Rutger505/real-life-soundboard/(list of files, cad)

Other CAD files:
esp32/case/real-live-soundboard.scad
