Rutger505/real-life-soundboard/(commit log)

2026-08-01 Initial commit: ESP32 BLE firmware + Android Compose soundboard app
2026-08-01 Android: run BLE + audio in a foreground service
    Move BLE connection and playback into SoundboardService so the soundboard
    keeps working while the phone is used normally, screen off, or app closed.
    Ongoing notification shows connection status and the last pressed button.
2026-08-01 esp32: pin esp Rust toolchain via rust-toolchain.toml
    Fixes 'can't find crate for core' — the Xtensa target requires the esp
    toolchain installed by espup, not the default stable toolchain.
2026-08-01 Fix builds: bump esp-idf crates for c_char fix + add kotlin-android plugin
    esp32: bump esp-idf-svc 0.49->0.52 and esp-idf-hal 0.44->0.46 (embuild 0.33)
    to fix the 'c_char vs i8' compile error on newer Xtensa rustc toolchains
    (esp-idf-svc #570, fixed in 0.52.0).
    android: add missing kotlin-android plugin alias to libs.versions.toml that
    app/build.gradle.kts references.
2026-08-01 esp32: bump ESP-IDF to v5.4.2 to match esp-idf-svc 0.52
    esp-idf-svc 0.52 references BLE symbols (esp_ble_gattc_enh_open,
    esp_ble_conn_params_t, ble_llcp_disc_flag, esp_ble_resolve_adv_data_by_type)
    that only exist in ESP-IDF 5.3+. Pinning v5.2.2 caused ~18 unresolved-symbol
    errors inside esp-idf-svc.
2026-08-01 esp32: rewrite BLE server for esp-idf-svc 0.52 API + create GATT service
    - Adapt to esp-idf-hal 0.46 / esp-idf-svc 0.52 API:
    - PinDriver is now single-generic and type-erased -> buttons in one array
    - PinDriver::input takes Pull; set_pull is private
    - BtDriver<'d, Ble> mode marker instead of BleEnabled trait
    - GattsEvent variants: ServiceRegistered{app_id}, ServiceCreated,
    CharacteristicAdded, DescriptorAdded, PeerConnected/PeerDisconnected, Write
    - Actually create the service + notify characteristic + CCCD (0x2902) so
    button presses are sent as BLE notifications (previously never created,
    so nothing was ever sent). Notify all subscribed connections with [index].
    - Restart ad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
2026-08-01 esp32: drop needless mut on buttons array
2026-08-01 esp32: make LED blink non-blocking
    Replace the sleeping blink_led() with a timestamp-driven LedBlinker that the
    main loop advances each tick, so button scanning and BLE notifications are no
    longer stalled ~320ms per press.
    [main.rs]
2026-08-01 esp32: move button 1 (index 1) off GPIO5 to GPIO23
    GPIO5 is a strapping pin and reads unreliably as an input on some boards.
    GPIO23 is a plain GPIO. Update wiring table accordingly.
2026-08-01 android: preload audio for instant playback
    Pressing play was slow because each press did setDataSource + prepare()
    (blocking I/O) on a fresh MediaPlayer. Now each slot keeps a MediaPlayer
    prepared ahead of time (prepareAsync); a press only does seekTo(0)+start().
    Service preloads all slots on start and on config change (ACTION_RELOAD),
    triggered from ViewModel.setAudioFile.
2026-08-01 android: fix crash when replacing a slot's audio file
    preload() released the old MediaPlayer but left 'current' dangling to it;
    the next play() called isPlaying() on the released player -> IllegalStateException.
    Clear 'current' when releasing that player, mirroring clear().
2026-08-01 esp32: restructure firmware around idle power draw
    The device runs off a small LiPo on the wrist, so battery life is decided
    by what the chip does while nothing happens. Split main.rs into ble,
    buttons, led and power modules and tune each for that.
    - buttons: replace the 20 ms poll loop, which woke the CPU 50x/s for nine
    register reads, with GPIO interrupts that unblock the main task. GPIO
    wakeup from light sleep is level-triggered only and gpio_wakeup_enable
    writes the pin's interrupt type, so the pins trigger on low level and are
    only re-armed once every button reads released again -- which is also
    what stops a held button from re-triggering.
    - power: esp_pm_configure at 80/40 M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
    [ble.rs, buttons.rs, led.rs, main.rs, power.rs]
2026-08-04 android: MyInstants integration + move BLE status to bottom
    Add an in-app MyInstants browser so users can find and add sounds without
    leaving the app: search/trending backed by the unofficial MyInstants JSON
    API (myinstants-api.vercel.app), tap a result to download its mp3 into app
    storage and assign it to a slot. The downloaded file is preloaded by the
    service like any picked file, so playback stays instant.
    Each slot gets a search action next to the file picker. Downloads are
    served via a FileProvider and stored under filesDir/myinstants.
    Also move the ESP32 connection status from the top of the screen to a
    compact bar at the bottom, so it no longer sits under the camera cutout.
2026-08-04 android: low-power BLE reconnect backoff
    Reduce battery drain while the ESP32 is switched off. The first reconnect
    after a drop still scans aggressively (SCAN_MODE_LOW_LATENCY, 5s) for a fast
    recovery, but subsequent attempts back off to a steady 10s cadence using
    SCAN_MODE_LOW_POWER instead of hammering low-latency scans forever.
    The backoff counter resets on a successful connection, so a later drop
    retries quickly again.
2026-08-04 android: safe-area layout + always-available source row + play/trash row
    Three UI fixes:
    - Wrap the screen in safeDrawing insets and center the grid vertically, so
    content never lands under the camera cutout / status bar and sits in the
    usable middle of the screen.
    - Keep both source pickers (local file + MyInstants search) available at all
    times, so a filled slot can still be re-sourced from MyInstants.
    - When a slot has audio, show a second row with play + trash (empty slot)
    actions, backed by a new clearSlot() on the ViewModel.
2026-08-05 android: always show play/trash row (disabled when slot is empty)
    Split slot actions into a source row and a playback row, and always render
    play/trash instead of conditionally hiding them. When no sound is loaded the
    playback actions are disabled/greyed rather than removed, so the buttons are
    visible on every tile. Bumped tile min-height to fit both rows.
2026-08-05 android: overlay slot buttons so the sound name stays visible
    Wrap the tile in a Box and overlay the 2x2 action buttons at the bottom
    (position:absolute-style) instead of stacking them in the column. The number
    and name are centered and fill the tile, so the name is no longer pushed out
    by the button rows.
2026-08-05 android: drop absolute-style overlay, use natural-size flow
    Replace the Box overlay with a plain Column so every child (number, sound
    name, source row, playback row) takes its own natural size and the tile grows
    to fit. The selected sound name is no longer clipped or covered by buttons.
2026-08-16 esp32: use internal pull-down resistors for buttons
    Switch button inputs from internal pull-ups to pull-downs (press = high),
    inverting the interrupt/level/scan logic accordingly. No external resistors
    needed; wire each button between its GPIO and 3.3V.
    Move the two strapping pins GPIO12/GPIO15 to GPIO25/GPIO26, which are unsafe
    at boot when driven by a pull-down.
    [buttons.rs, main.rs]
2026-08-17 docs: update wiring for pull-down buttons (GPIO12/15 -> 25/26)
2026-08-18 esp32: rewrite firmware from ESP-IDF std to bare-metal no_std
    Replace the ESP-IDF/std stack (esp-idf-svc/-hal, Bluedroid, embuild,
    sdkconfig.defaults) with a true bare-metal no_std build on esp-hal +
    Embassy (esp-rtos) + the esp-radio BLE controller + the trouble-host
    GATT stack. Target is now xtensa-esp32-none-elf.
    Behavior is preserved exactly:
    - GATT server "Soundboard", service 12345678-…-9012, notify characteristic
    12345678-…-9abc (+ auto CCCD 0x2902); one byte = button index on press.
    - Advertise until connected (single connection), 100–200 ms interval; the
    controller stops advertising on connect. Low-power connection params
    (30–45 ms interval, 20-event slave latency, 4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
    [ble.rs, build.rs, buttons.rs, led.rs, main.rs, power.rs]
2026-08-20 Refactor esp32 comments: strip AI tells (em dashes, colon crutches)
2026-08-20 Rewrite esp32 comments: shorter, less noise
    [ble.rs, buttons.rs, led.rs, main.rs]
2026-08-29 case: add printed enclosure and document it
    Three-part OpenSCAD enclosure (tray, lid, button carrier plate) sized from
    the measured battery, ESP32, charger and buck-boost. The 3x3 button grid is
    centred on the case, so it sits above the ESP32 and that board sets the
    cavity depth.
    btn_leg is 3 mm, which leaves the switch legs standing 1.3 mm proud of the
    carrier plate. That is enough to solder the common 3.3 V rail and the nine
    signal wires from below once the plate is on, instead of wiring the switches
    before they go in.
    The lid has no LED window yet.
    [real-live-soundboard.scad]
2026-08-29 case: add a socket and light hole for the status LED
    The firmware has always driven a status LED on GPIO2 but the lid had no
    opening for it. The socket hangs from the lid underside like a button
    pocket and sits in the gap between the charger and the power switch, the
    one patch of the front band that no module and no carrier plate reaches,
    so it has the full cavity height.
    The light hole is 2.2 mm against a 3 mm body, so the LED is captured and
    cannot be pushed out through the top.
    [real-live-soundboard.scad]
2026-08-29 case: drop the strap lugs
    They were never going to be used, so this removes the lugs, their slots and
    the parameters behind them rather than leaving a disabled flag. The tray
    outline is now the plain rounded rectangle, 61.2 x 97.3 mm, with nothing
    sticking out past it.
    [real-live-soundboard.scad]
2026-08-29 case: size the LED socket on the measured lip, not the body
    The bore was 3.4 mm against a lip measured at 3.3, which leaves 0.05 mm a
    side on the widest part of the LED and will not go together once print
    tolerance is counted. The bore still grips the 3.0 mm body, and the top
    1.2 mm now opens out to 3.7 mm so the lip has somewhere to sit.
    [real-live-soundboard.scad]
2026-08-29 case: move the status LED to the front right corner
    It sat mid-front between the charger and the switch, which reads as an
    arbitrary spot on the lid. Over the power switch it lines up with the other
    thing you interact with, and it is as far into the corner as the screw boss
    lets it go.
    The switch is 4 mm tall against a 12.6 mm cavity, so the socket still hangs
    free with 4.6 mm to spare, and it clears the lid lip by 0.95 mm.
    [real-live-soundboard.scad]
2026-08-30 case: ignore generated STLs
    Claude-Session: https://claude.ai/code/session_01Srfqsck5U9y2Wjd3d172or
2026-08-30 case: stand the charger off the tray floor
    The TP4056 is linear, so it dissipates the drop from 5 V to the cell as
    heat. Averaged over the case that is a few degrees and harmless, but the
    module sat flat on 1.2 mm of floor, and the patch under the chip conducts
    rather than convects. Four 3 mm pads lift it 1.5 mm so it radiates into the
    cavity instead.
    The corner retainers grew by the same 1.5 mm to keep holding the board at
    its own edges, and the USB-C opening moved up with the connector.
    [real-live-soundboard.scad]
2026-09-07 case: compact layout, merge retainers into walls and band dividers
    [real-live-soundboard.scad]
2026-09-07 case: fix dividers being cut away, keep LED relative to the wall, add charger ribs
    [real-live-soundboard.scad]
2026-09-07 case: buck-boost against the left wall, out of the charger rib
    [real-live-soundboard.scad]
2026-09-07 case: add open part option (assembly without lid)
    [real-live-soundboard.scad]
2026-09-13 esp32: read the buttons as a 3x3 matrix
    The nine buttons sit in a 3x3 grid, so wire them as a matrix: 6 GPIOs
    instead of 9, and 6 wires out of the lid instead of 10.
    Rows (GPIO25/26/27) are inputs with the internal pull-up, columns
    (GPIO17/16/4) are open-drain outputs. Open-drain means a column can only
    pull low, so two keys held in one row can't short two outputs together.
    While idle all columns sit low and the task sleeps on the rows; it only
    scans while a key is down. A press reports immediately, a release needs
    four clean 5 ms scans, so bounce can't send twice. Indices stay 0..=8, so
    the app needs no change.
    README documents the pins, the index layout and optional diodes against
    ghosti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
    [buttons.rs, main.rs]
2026-09-13 case: open ESP32 corners, roomier battery, key caps
    The battery squeezed hard enough to damage its leads. Its pocket is now
    1 mm wider and 3 mm longer, and at both front corners (facing the ESP32)
    the front and side ribs stop 10 mm short so the leads can bend freely.
    The ESP32 dividers are gone. Four corner posts against the side walls
    hold the board and carry the button plate, so both pin rows are open for
    wires soldered straight onto the board. The plate sits 8 mm higher over
    the board and gets ribs under its front and back edges, since it now
    spans the full width.
    The bare 3.3 mm actuators were hard to press. Each button gets a printed
    cap with a 7 mm dished top in a lid bore, held in b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
    [real-live-soundboard.scad]
2026-09-13 esp32: move status LED to GPIO18, explain matrix orientation
    GPIO2 also drives the dev board's own LED. GPIO18 sits on the column
    header, is not a strapping pin and has nothing else on it.
    The README now says what a row and a column are, how the layout flips
    when soldering with the lid face down, and what open-drain means.
    Claude-Session: https://claude.ai/code/session_014j6BBzmt3zrMWTHAtd3faS
    [real-live-soundboard.scad]
2026-09-13 docs: describe the actual bare-metal ESP32 setup
    The firmware moved to bare-metal esp-hal + esp-radio + trouble-host, but
    the README still described the old ESP-IDF (std) build:
    - target is xtensa-esp32-none-elf, not xtensa-esp32-espidf, so the
    documented espflash path pointed at a binary that is never produced
    - no ESP-IDF and no ldproxy are involved any more
    - project structure still listed esp-idf-hal / esp-idf-svc
    Also note that espup must be installed from $HOME rather than esp32/
    (rust-toolchain.toml pins the 'esp' channel before it exists), that
    build-std recompiles core/alloc so a cold build takes ~7 min, and why
    the esp-*/trouble-host git revisions are pinned.
    Android: state th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
2026-09-15 case: flat lid, button pockets on the plate, tolerance fixes
    The key caps are gone. The buttons sit in pockets on the carrier plate
    and the lid is a flat 1.6 mm plate dropped into a rim on the tray. Each
    key gets a dished hole around the actuator, with square holes for the
    corner nubs. The status LED moves from a socket under the lid to a
    bracket on the tray wall, above the power switch.
    Fixes after going through the fits and the print geometry:
    - The nub holes get their own 0.4 mm clearance and are centred on the
    nubs, which measure 1.4 mm. Button, plate and lid play used to add up
    to more than the old 0.2 mm. The actuator hole is 4.4 mm.
    - Pocket walls and plate ribs stop 0.3 mm unde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
    [real-live-soundboard.scad]
2026-09-15 case: charger along the left wall, battery against the back wall
    The charger turns 90 degrees and its USB-C port moves to the left wall,
    opposite the power switch. The buck-boost fits between the charger and
    the switch, so the front band is 23.4 mm deep instead of 28.2 mm. The
    buck-boost only has corner arms on its right side, which leaves 2.5 mm
    for the switch pins. Trim them short before soldering.
    The back wall of the case is now the back of the battery pocket. The
    four bosses moved 0.5 mm closer to their corners and the front left one
    is slim too, so it clears the charger and the rear ones clear the cell.
    The countersinks still keep 0.5 mm of lid corner.
    Body is now 56.0 x 90.7 x 23.2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
    [real-live-soundboard.scad]
2026-09-15 case: hanging corner bosses, charger and battery move up
    Three of the four bosses no longer stand on the floor. Each starts at
    the bottom of its pilot hole and tapers into its corner at 45 degrees or
    steeper, so it prints without supports and leaves the floor free. The
    battery pocket loses the bump the rear bosses made in it, and the
    charger moves forward as far as the cavity corner allows, with the front
    wall filled in up to it instead of a rib. The front right boss still
    stands on the floor, next to the switch and the LED.
    The battery front rib now sits in line with the rear ESP32 posts
    instead of behind them.
    Body is now 56.0 x 87.4 x 23.2 mm.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
    [real-live-soundboard.scad]
2026-09-16 docs: drop the enclosure section
    It described the old case with printed key caps, a pocketed lid and a
    front USB-C port, none of which match case/real-live-soundboard.scad
    any more. The case/ line goes from the project structure as well.
2026-09-27 esp32: take embassy-executor-timer-queue from the executor's git rev
    embassy-executor is patched to a git rev, but esp-rtos reached the timer
    queue through embassy-time-queue-utils, which pulled the crates.io copy of
    embassy-executor-timer-queue. Timers were queued in one copy and serviced
    from the other, so no Timer::after ever woke its task: the matrix froze
    after the first press and the connection-params request never ran.
2026-09-27 esp32: stop requesting low-power connection params for now
    Now that timers fire, the request actually goes out one second after
    connect. One phone connection dropped with a supervision timeout right
    after it, so leave it off until it is tested with the app.
2026-09-27 esp32: request low-power connection params again
    The phone app stayed connected for 20 minutes after the request, with
    presses still arriving. The earlier supervision timeout came from a pairing
    attempt in Android's Bluetooth settings, which this firmware does not
    support, not from the request.
2026-09-27 esp32: compile out logs below warn
    esp-println's ESP_LOG only filters at run time; the format code stays in
    the binary. log's release_max_level_warn removes info/debug/trace from
    every crate at compile time (-19 KB of image), and ESP_LOG matches it.
2026-09-27 esp32: 0.2.0
2026-10-01 Fix pins in main
    [main.rs]
2026-10-01 Android: 3x2 grid using only ESP buttons 3-8
2026-10-03 Add battery level TODO to README
2026-10-25 esp32: report battery level over BLE
    A 100k/100k divider from the power switch output feeds GPIO34 (ADC1).
    The firmware averages 32 samples, converts them with ESP-IDF's 11 dB line
    fit and the eFuse Vref (esp-hal has no ADC calibration for the classic
    ESP32), and maps the cell voltage to percent with a resting LiPo curve.
    - Standard Battery Service 0x180F / Battery Level 0x2A19 (0-100 %).
    - Custom characteristic ...789abd: cell mV (u16 LE) + charging state
    (always 0 = unknown until CHRG is wired).
    - Measured on every press before it is sent, every 30 min, and once
    after connecting. Notifies only when the percentage changes.
    Row 2 moves from GPIO32 to GPIO14, so GPIO32/33 stay free for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
2026-10-25 README: spell out the app side of the battery level
2026-10-25 Android: show battery level, nerd stats and a battery life estimate
    Subscribes to Battery Level and Battery (raw) through a queued GATT op chain
    (button first, battery optional for older firmware) and reads both once.
    Samples since the last detected charge are persisted and fitted to estimate
    drain, average current and time remaining.
2026-10-26 esp32: port the firmware back to Rust + ESP-IDF (0.4.0)
    Bare-metal esp-radio keeps BLE sleep disabled, so the 32.768 kHz crystal
    could never pay off. Move to esp-idf-svc 0.53 / esp-idf-hal 0.47 on
    ESP-IDF v5.5.5 (Bluedroid), target xtensa-esp32-espidf, linked by ldproxy.
    Same behaviour and wire format, so the app works with either firmware:
    - 3x3 matrix on rows 25/14/13 (pull-up) and open-drain columns 17/16/4,
    woken by a low-level GPIO interrupt (also a light-sleep wakeup source),
    scanned every 5 ms only while a key is down.
    - LED on GPIO18, 60 ms flash through an esp_timer.
    - GATT: soundboard service with button + battery raw, Battery Service
    0x180F / Battery Level, all read+notify,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
2026-11-01 esp32: 32.768 kHz crystal and light sleep by default, cargo run in README (0.5.0)
2026-11-01 nrf52: port the firmware to the XIAO nRF52840 (0.1.0)
    Embassy + nrf-sdc + TrouBLE, flashed over SWD with probe-rs. Same matrix
    logic, LED, GATT services and UUIDs as the ESP32 firmware. Low power:
    32.768 kHz crystal, DC/DC, QSPI flash in deep power-down, GPIO sense wakeup,
    peripheral latency, fast-then-slow advertising. Battery through the XIAO's
    own divider, charging state from the charger's status pin.
2026-11-01 Android: show the nRF52's charging state (1.7)
2026-11-01 case: move into esp32/, new nRF52 case, part dropdown
    The ESP32 case moves to esp32/case. nrf52/case is a new, smaller case for
    the XIAO build (47.6 x 65.3 x 20.9 mm): XIAO on rails with USB-C out the
    left wall, switch and LED in the front band, LiPo under the button plate.
    Tolerances and the part dropdown follow the motorized-blinds remote.
2026-11-01 README: actual ESP32 case size
2026-11-02 nrf52 case: hanging bosses, cell and XIAO into the corners, tighter switch
2026-11-02 nrf52 case: 1 mm lower, silicone matrix wires need less room
2026-11-02 nrf52 case: plate right over the cell, rear bosses behind it (18.1 mm high, 5 mm longer)
2026-11-02 esp32 case: SolidCraft version of the OpenSCAD case (.sc)
2026-11-07 Android: Share logs with battery samples and raw battery values (1.9)
2026-11-07 Android: app icon (3x3 button grid with speaker), adaptive + themed, matching notification icon (1.10)
